PA0MHE/CNBL-10G-Addon-module/CNBL 10GHz V03.jpg

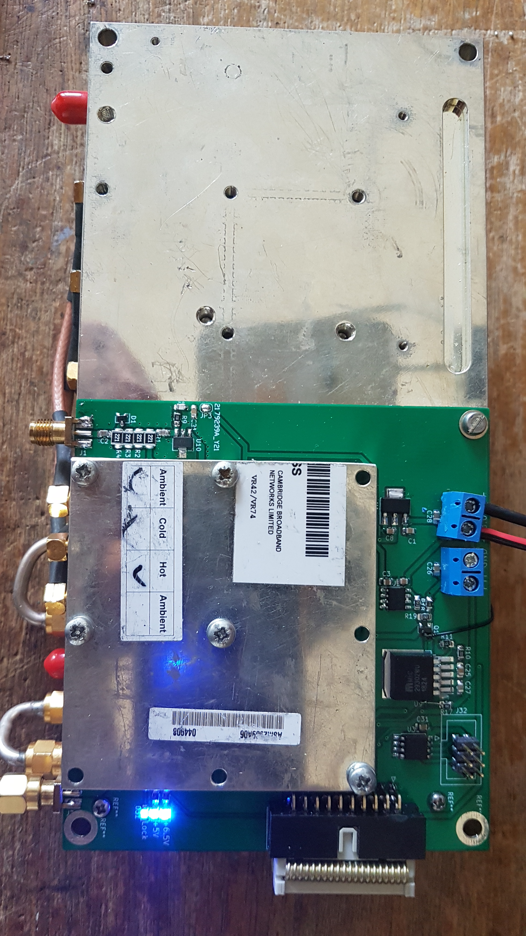
CNBL 10GHz V03.jpg
