PA0MHE/CNBL-10G-Addon-module/3D PCB.JPG

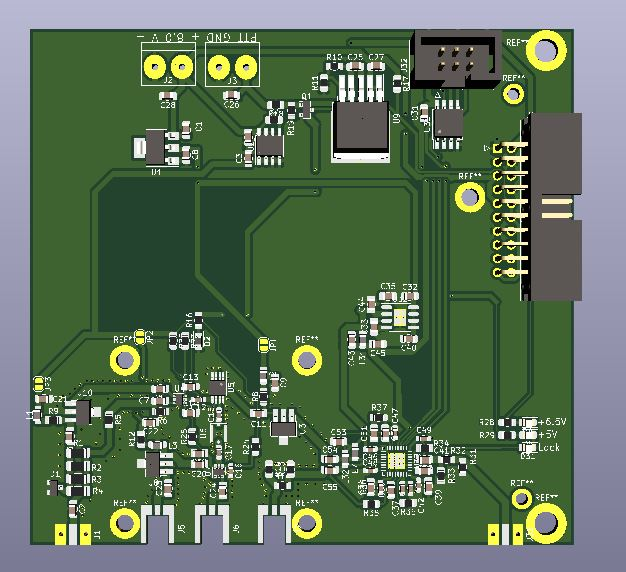
3D PCB.JPG
