PA0MHE/CNBL-10G-Addon-module/CNBL 10G v031 schematic.pdf

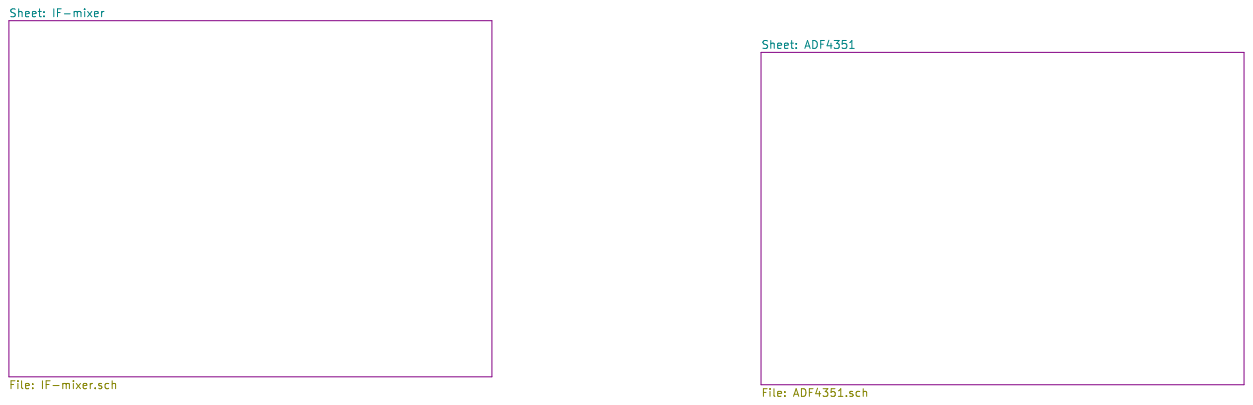
[picture p3: page 1]

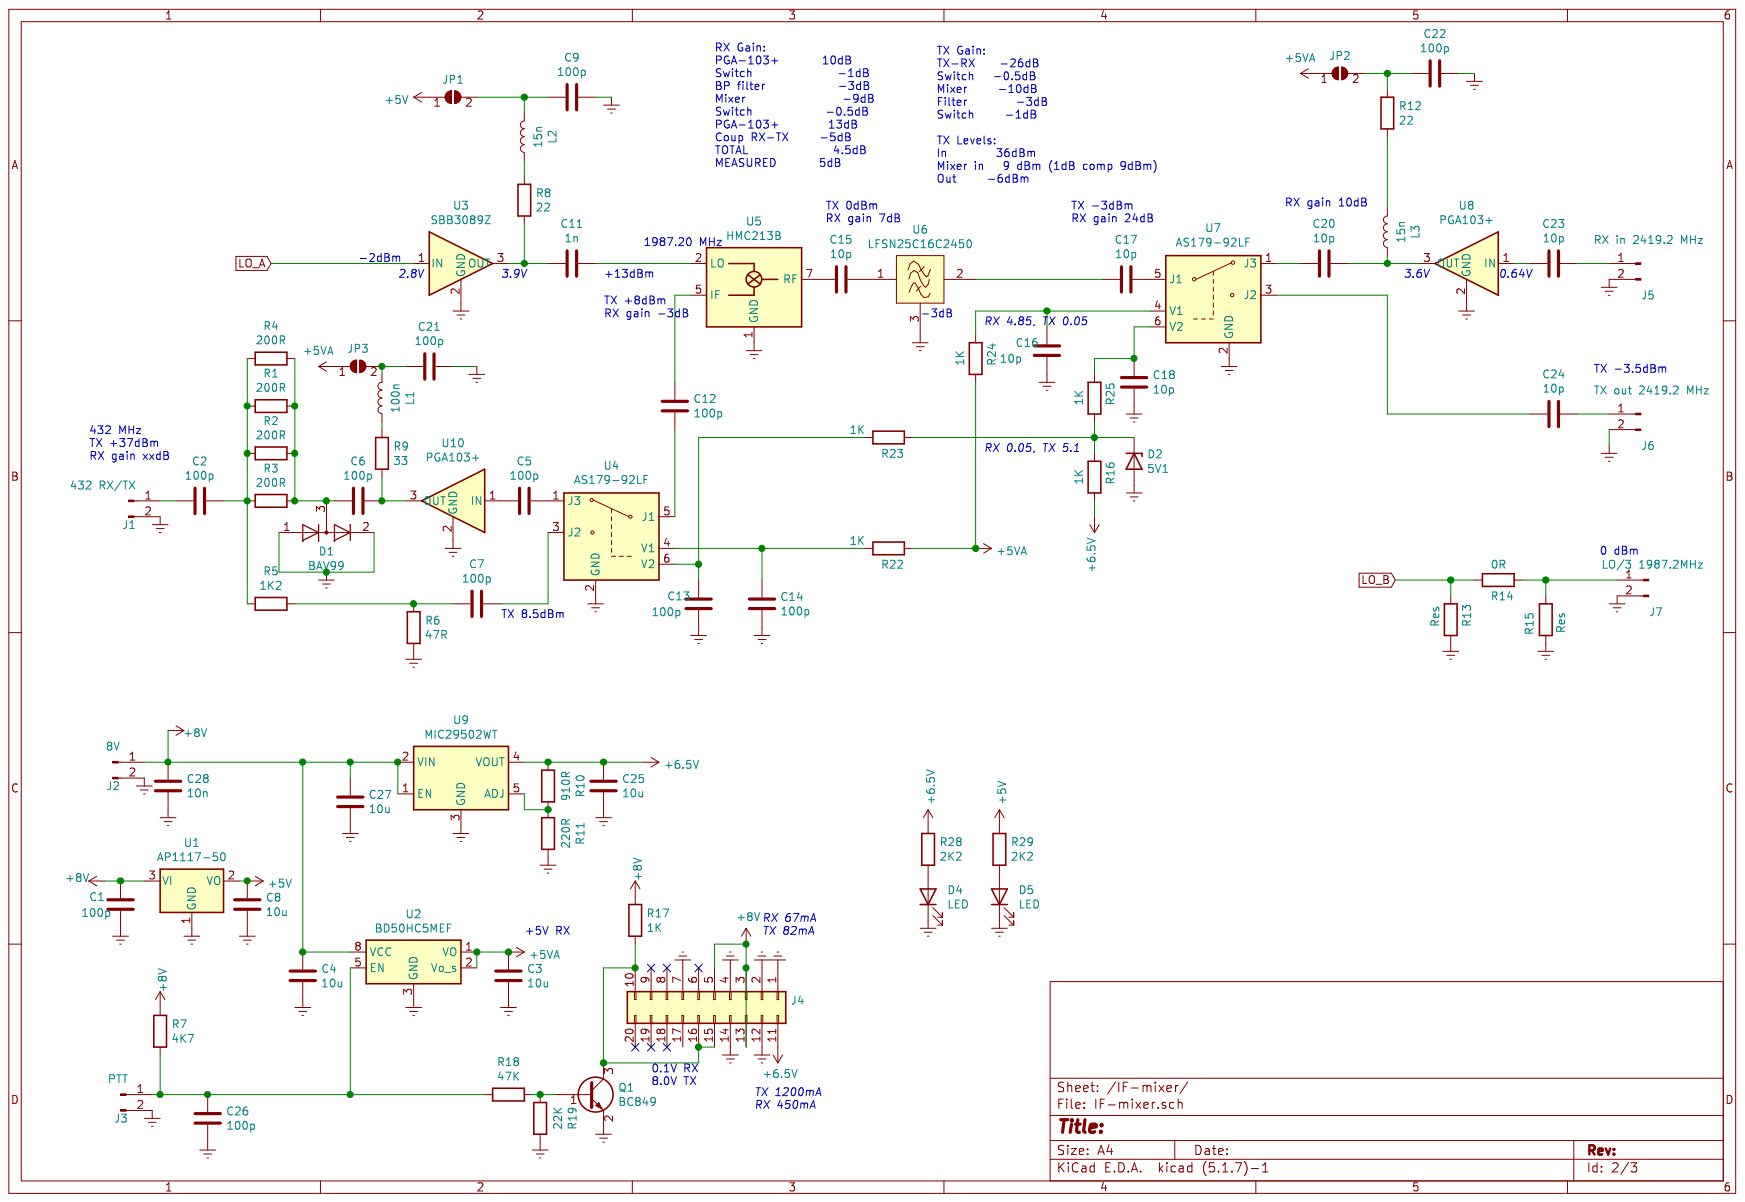
[picture p4: page 2]

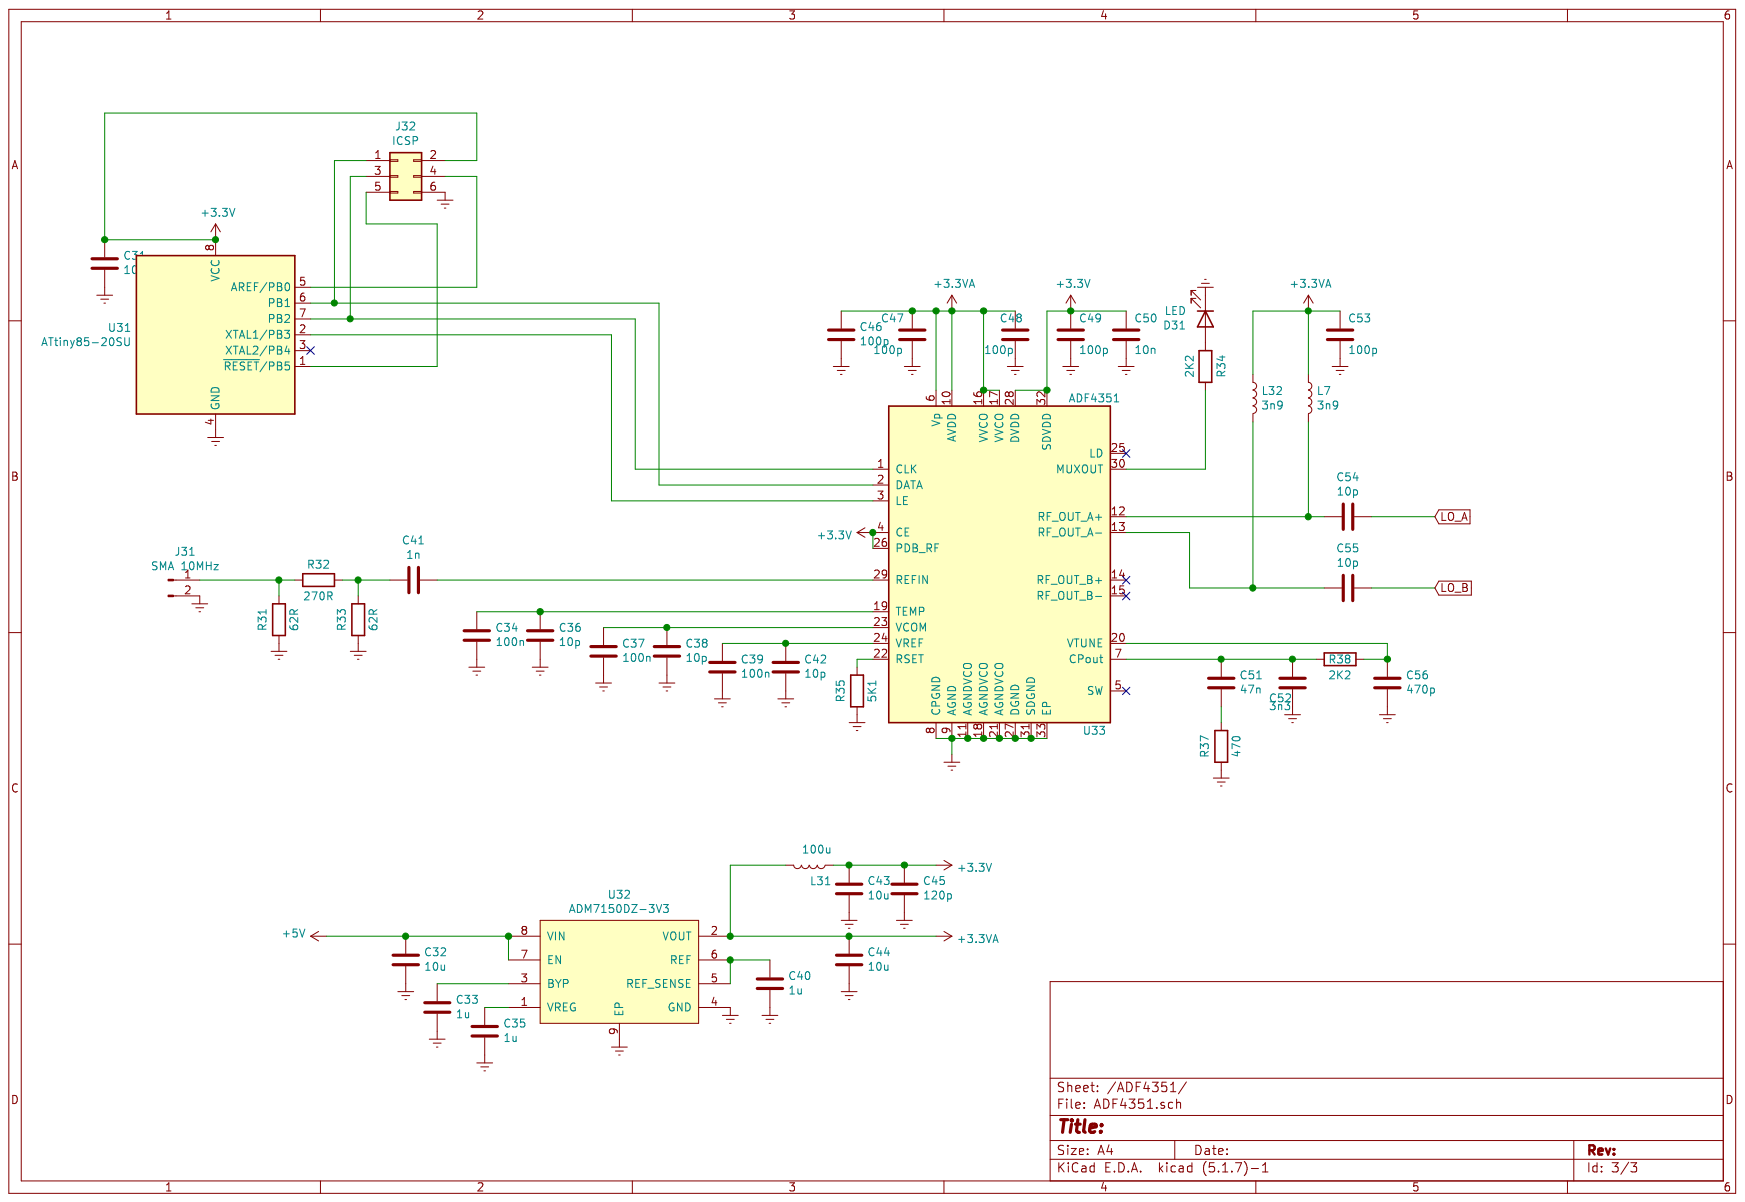
[picture p5: page 3]
