PA0MHE/CNBL-10G-Addon-module/Kicad 5 - CBNL 10GHz TRV v03/CBNL_10GHz_TRV.kicad_pcb

## KiCad design Kicad 5 - CBNL 10GHz TRV v03/CBNL_10GHz_TRV.kicad_pcb (2022-08-22)

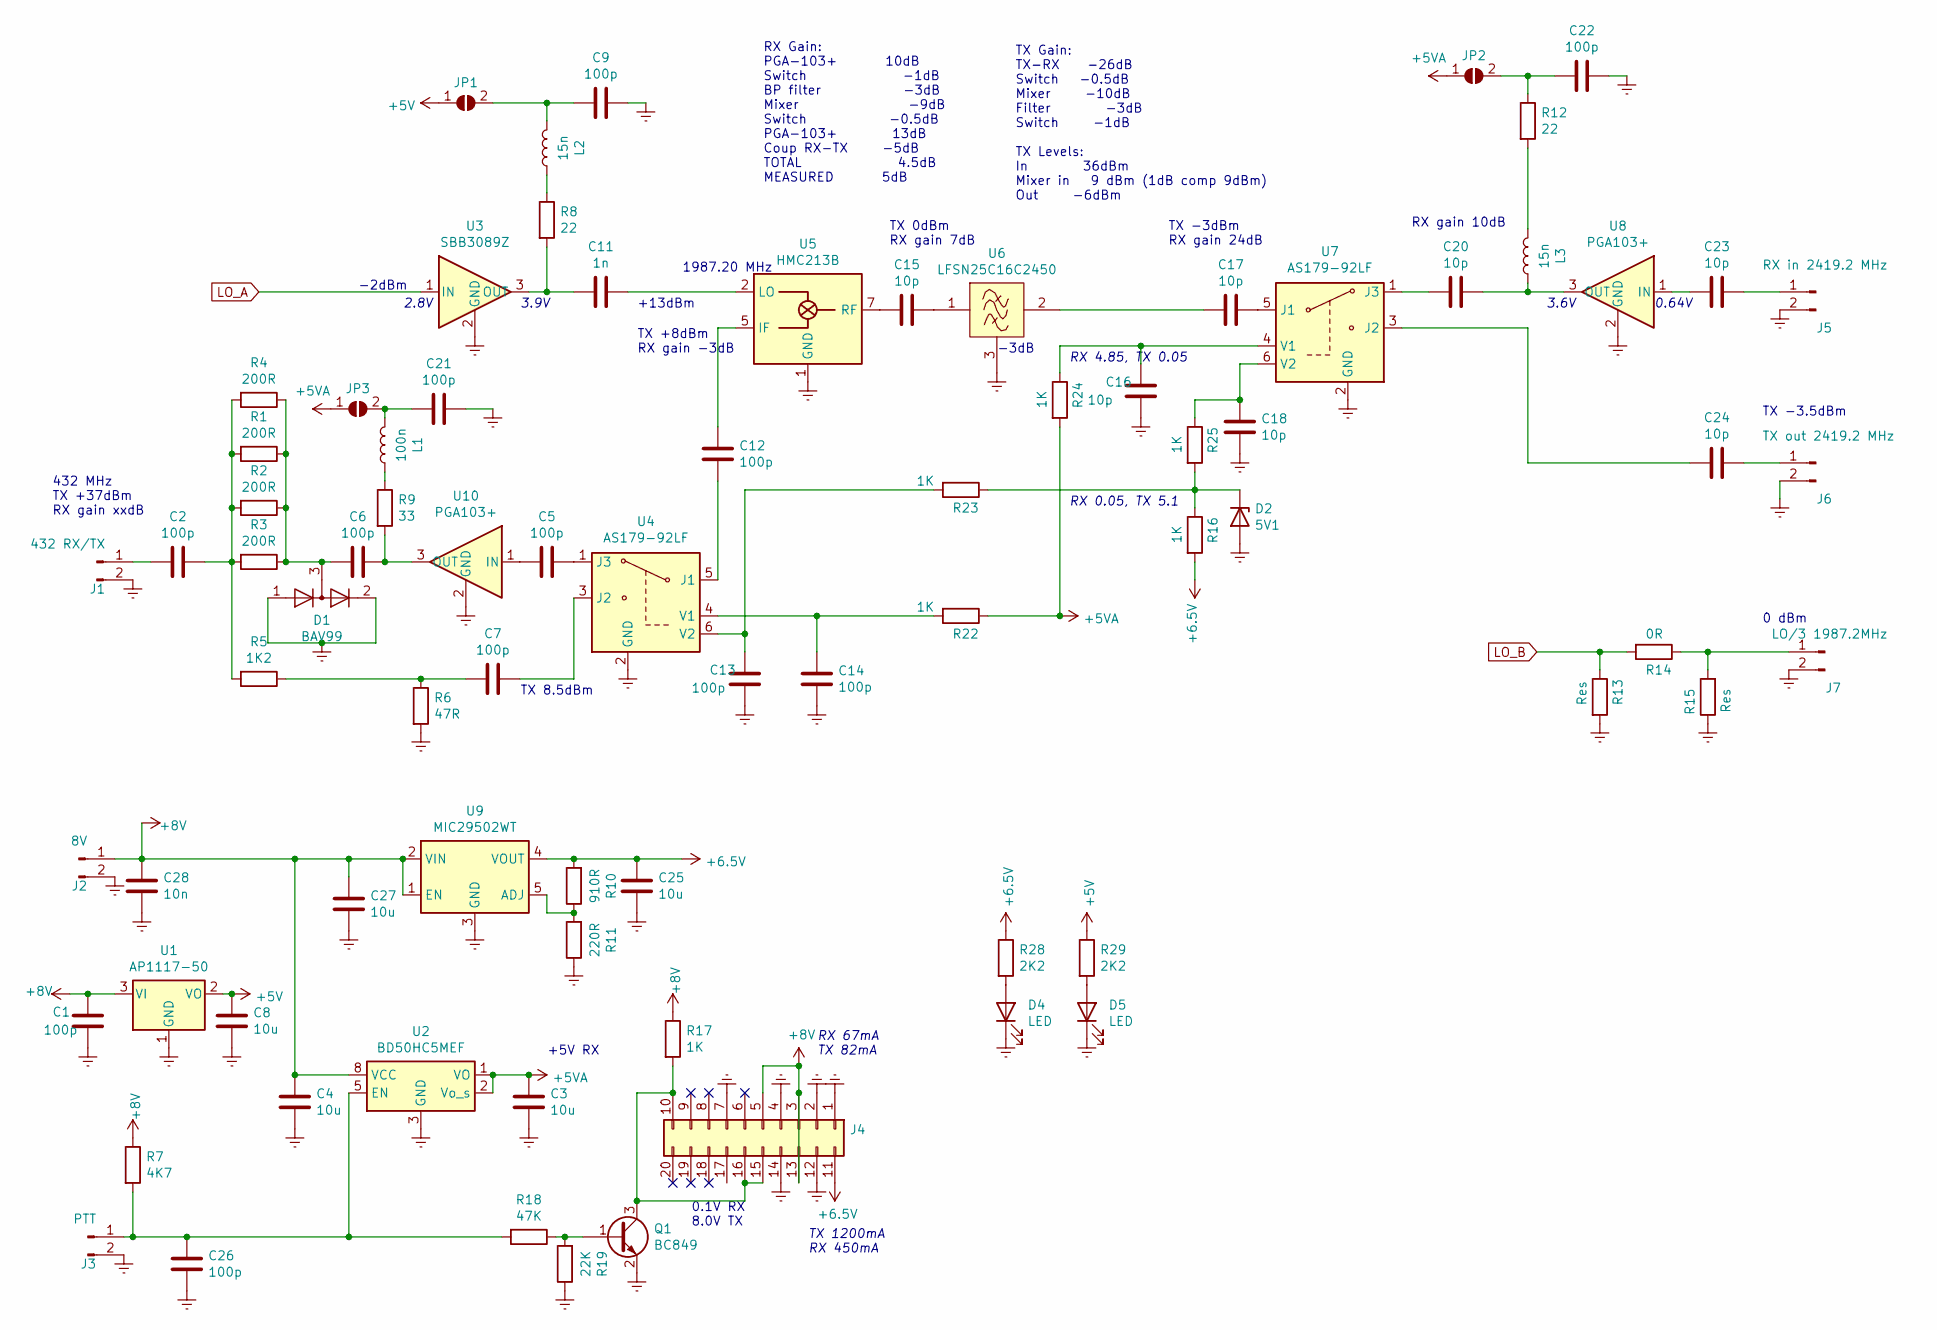
[picture p6: schematic IF-mixer.sch]

Parts:
C1, C2, C5, C6, C7, C9, C13, C14, C21, C22, C26: 100p; C_0805_2012Metric_Pad1.18x1.45mm_HandSolder
C3, C4, C8, C25, C27: 10u; C_0805_2012Metric_Pad1.18x1.45mm_HandSolder
C11: 1n; C_0805_2012Metric_Pad1.18x1.45mm_HandSolder
C12: 100p; C_0603_1608Metric_Pad1.08x0.95mm_HandSolder
C15, C16, C17: 10p; C_0603_1608Metric_Pad1.08x0.95mm_HandSolder
C18, C20, C23, C24: 10p; C_0805_2012Metric_Pad1.18x1.45mm_HandSolder
C28: 10n; C_0805_2012Metric_Pad1.18x1.45mm_HandSolder
D1: BAV99; SOT-23
D2: 5V1; D_0805_2012Metric_Pad1.15x1.40mm_HandSolder
D4, D5: LED; LED_0805_2012Metric_Pad1.15x1.40mm_HandSolder
J1: 432 RX/TX; SMA_side_PCB
J2: 8V; KF301-2P
J3: PTT; KF301-2P
J4: Conn_02x10_Top_Bottom; IDC-Header_2x10_P2.54mm_Horizontal_MH
J5: RX in 2419.2 MHz; MCX
J6: TX out 2419.2 MHz; MCX
J7: LO/3 1987.2MHz; MCX
JP1, JP2, JP3: option; SolderJumper-2_P1.3mm_Open_RoundedPad1.0x1.5mm
L1: 100n; L_0805_2012Metric_Pad1.05x1.20mm_HandSolder
L2, L3: 15n; L_0805_2012Metric_Pad1.05x1.20mm_HandSolder
Q1: BC849; SOT-23
R1, R2, R3, R4: 200R; R_1206_3216Metric_Pad1.30x1.75mm_HandSolder
R5: 1K2; R_0805_2012Metric_Pad1.20x1.40mm_HandSolder
R6: 47R; R_0805_2012Metric_Pad1.20x1.40mm_HandSolder
R7: 4K7; R_0805_2012Metric_Pad1.20x1.40mm_HandSolder
R8, R12: 22; R_0805_2012Metric_Pad1.20x1.40mm_HandSolder
R9: 33; R_0805_2012Metric_Pad1.20x1.40mm_HandSolder
R10: 910R; R_0805_2012Metric_Pad1.20x1.40mm_HandSolder
R11: 220R; R_0805_2012Metric_Pad1.20x1.40mm_HandSolder
R13, R15: Res; R_0805_2012Metric_Pad1.20x1.40mm_HandSolder
R14: 0R; R_0805_2012Metric_Pad1.20x1.40mm_HandSolder
R16, R17, R22, R23, R24, R25: 1K; R_0805_2012Metric_Pad1.20x1.40mm_HandSolder
R18: 47K; R_0805_2012Metric_Pad1.20x1.40mm_HandSolder
R19: 22K; R_0805_2012Metric_Pad1.20x1.40mm_HandSolder
R28, R29: 2K2; R_0805_2012Metric_Pad1.20x1.40mm_HandSolder
U1: AP1117-50; SOT-223-3_TabPin2
U2: BD50HC5MEF; HTSOP-8-1EP_3.9x4.9mm_P1.27mm_EP2.4x3.2mm
U3: SBB3089Z; SOT-89-3_Handsoldering
U4, U7: AS179-92LF; SOT-363_SC-70-6
U5: HMC213B; MSOP-8_3x3mm_P0.65mm
U6: LFSN25C16C2450; LFSN25N
U8, U10: PGA103+; SOT-89-3_Handsoldering
U9: MIC29502WT; TO-263-5_TabPin6

Connections:
+5V: C8.1, JP1.1 (A), R29.1, U1.2 (VO); also elsewhere on the board
+5VA: C3.1, JP2.1 (A), JP3.1 (A), R22.1, R24.2, U2.1 (VO), U2.2 (Vo_s)
+6.5V: C25.1, J4.11, R10.2, R16.2, R28.1, U9.4 (VOUT)
+8V: C1.1, C4.1, C27.1, C28.1, J2.1, J4.3, J4.5, J4.13, R7.1, R17.1, U1.3 (VI), U2.8 (VCC), U9.1 (EN), U9.2 (VIN)
GND: C1.2, C3.2, C4.2, C8.2, C9.1, C13.2, C14.2, C16.2, C18.2, C21.1, C22.1, C25.2, C26.2, C27.2, C28.2, D1.1 (K), D1.2 (A), D2.2 (A), D4.1 (K), D5.1 (K), J1.2, J2.2, J3.2, J4.1, J4.2, J4.4, J4.7, J4.12, J4.14, J5.2, J6.2, J7.2, Q1.2 (E), R6.2, R11.1, R13.2, R15.1, R19.1, U1.1 (GND), U2.3 (GND), U2.4 (GND), U2.6 (GND), U2.7 (GND), U2.9 (GND), U3.2 (GND), U4.2 (GND), U5.1 (GND), U5.3 (GND), U5.4 (GND), U5.6 (GND), U5.8 (GND), U6.3, U6.4, U7.2 (GND), U8.2 (GND), U9.3 (GND), U10.2 (GND); also elsewhere on the board
LO_A: U3.1 (IN); also elsewhere on the board
LO_B: R13.1, R14.2; also elsewhere on the board
unnamed: C2.1, R1.2, R2.2, R3.2, R4.2, R5.2
unnamed: C2.2, J1.1
unnamed: C5.1, U4.1 (J3)
unnamed: C5.2, U10.1 (IN)
unnamed: C6.1, R9.2, U10.3 (OUT)
unnamed: C6.2, D1.3 (K), R1.1, R2.1, R3.1, R4.1
unnamed: C7.1, U4.3 (J2)
unnamed: C7.2, R5.1, R6.1
unnamed: C9.2, JP1.2 (B), L2.2
unnamed: C11.1, U5.2 (LO)
unnamed: C11.2, R8.2, U3.3 (OUT)
unnamed: C12.1, U5.5 (IF)
unnamed: C12.2, U4.5 (J1)
unnamed: C13.1, R23.2, U4.6 (V2)
unnamed: C14.1, R22.2, U4.4 (V1)
unnamed: C15.1, U6.1
unnamed: C15.2, U5.7 (RF)
unnamed: C16.1, R24.1, U7.4 (V1)
unnamed: C17.1, U7.5 (J1)
unnamed: C17.2, U6.2
unnamed: C18.1, R25.1, U7.6 (V2)
unnamed: C20.1, L3.1, U8.3 (OUT)
unnamed: C20.2, U7.1 (J3)
unnamed: C21.2, JP3.2 (B), L1.2
unnamed: C22.2, JP2.2 (B), R12.1
unnamed: C23.1, J5.1
unnamed: C23.2, U8.1 (IN)
unnamed: C24.1, J6.1
unnamed: C24.2, U7.3 (J2)
unnamed: C26.1, J3.1, R7.2, R18.2, U2.5 (EN)
unnamed: D2.1 (K), R16.1, R23.1, R25.2
unnamed: D4.2 (A), R28.2
unnamed: D5.2 (A), R29.2
unnamed: J4.10, J4.15, J4.16, Q1.3 (C), R17.2
unnamed: J7.1, R14.1, R15.2
unnamed: L1.1, R9.1
unnamed: L2.1, R8.1
unnamed: L3.2, R12.2
unnamed: Q1.1 (B), R18.1, R19.2
unnamed: R10.1, R11.2, U9.5 (ADJ)

Notes on the sheet:
1987.20 MHz
-2dBm
TX +8dBm RX gain -3dB
TX 0dBm RX gain 7dB
TX -3dBm RX gain 24dB
+13dBm
0 dBm
-3dB
TX -3.5dBm
RX gain 10dB
3.9V
2.8V
3.6V
0.64V
RX 4.85, TX 0.05
RX 0.05, TX 5.1
RX 67mA TX 82mA
TX 1200mA RX 450mA
TX 8.5dBm
432 MHz TX +37dBm RX gain xxdB
+5V RX
RX Gain: PGA-103+ 10dB Switch -1dB BP filter -3dB Mixer -9dB Switch -0.5dB PGA-103+ 13dB Coup RX-TX -5dB TOTAL 4.5dB MEASURED 5dB
TX Gain: TX-RX -26dB Switch -0.5dB Mixer -10dB Filter -3dB Switch -1dB TX Levels: In 36dBm Mixer in 9 dBm (1dB comp 9dBm) Out -6dBm
0.1V RX 8.0V TX

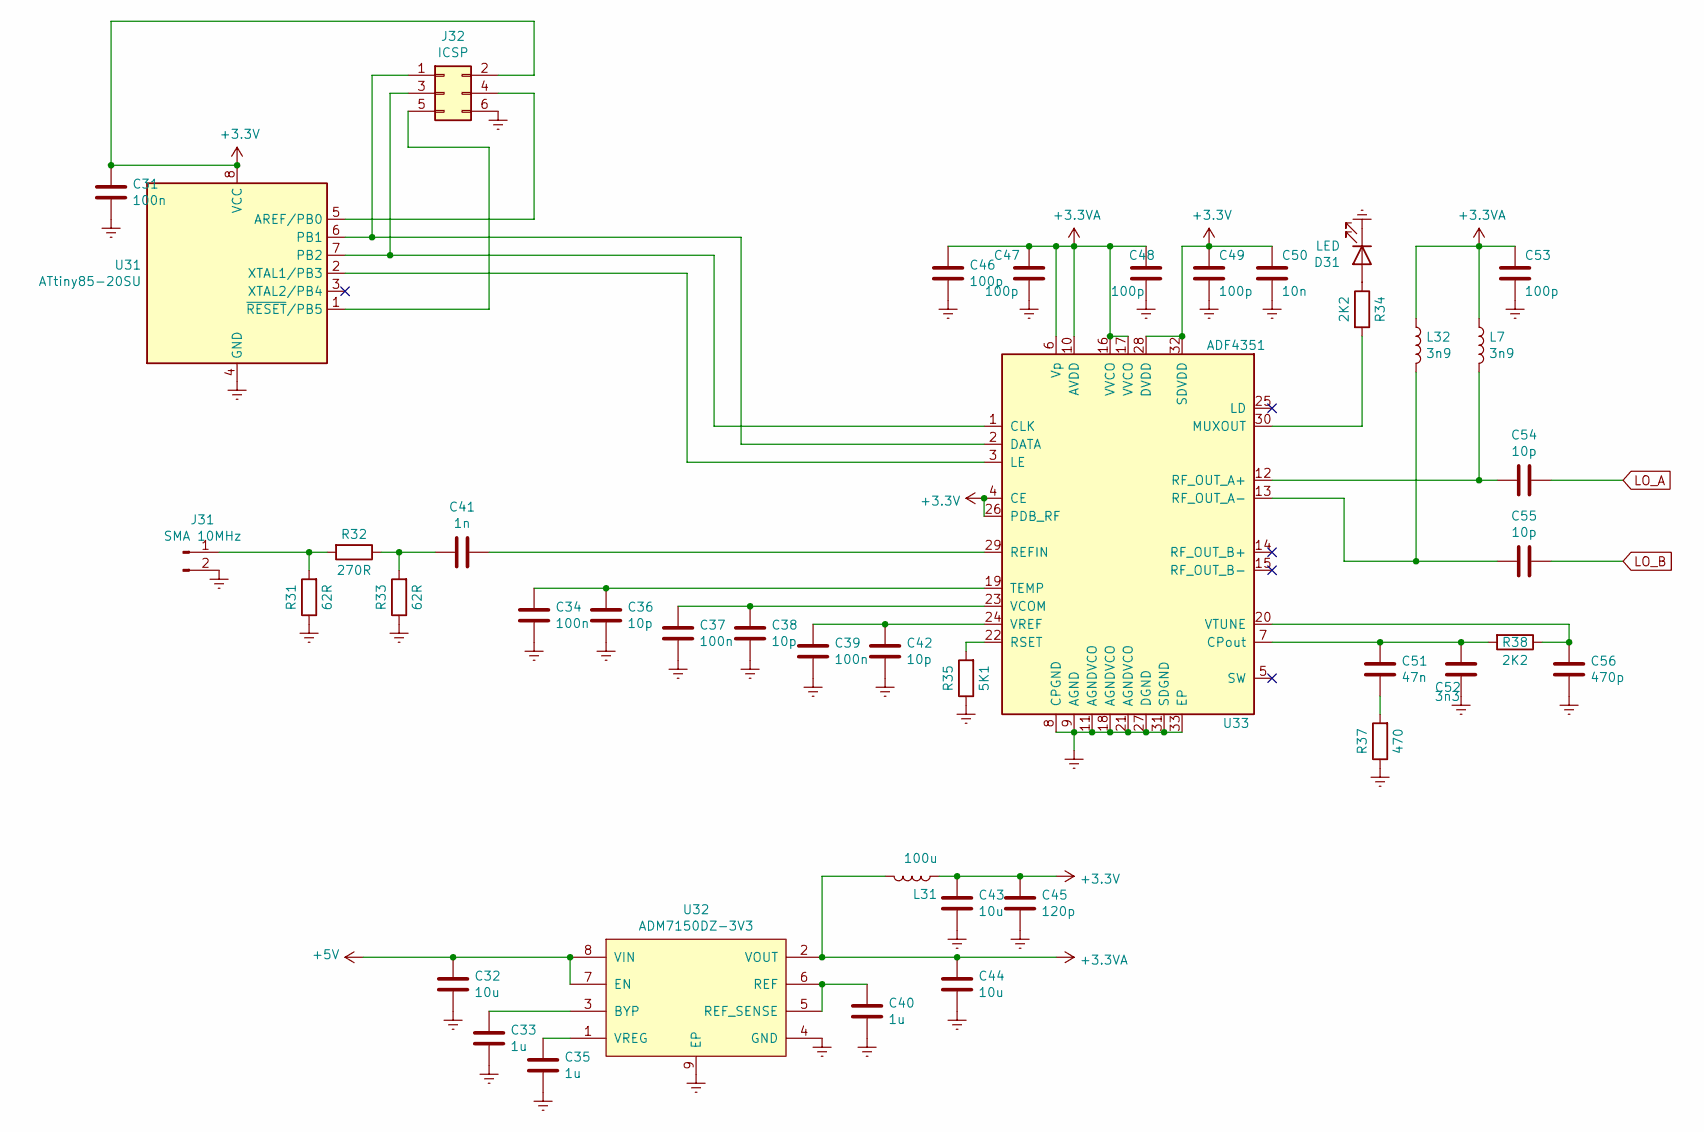
[picture p7: schematic ADF4351.sch]

Parts:
C31, C34, C39: 100n; C_0805_2012Metric_Pad1.18x1.45mm_HandSolder
C32, C43, C44: 10u; C_0805_2012Metric_Pad1.18x1.45mm_HandSolder
C33, C35, C40: 1u; C_0805_2012Metric_Pad1.18x1.45mm_HandSolder
C36, C38, C42: 10p; C_0603_1608Metric_Pad1.08x0.95mm_HandSolder
C37: 100n; C_0603_1608Metric_Pad1.08x0.95mm_HandSolder
C41: 1n; C_0805_2012Metric_Pad1.18x1.45mm_HandSolder
C45: 120p; C_0805_2012Metric_Pad1.18x1.45mm_HandSolder
C46, C47, C48, C49: 100p; C_0603_1608Metric_Pad1.08x0.95mm_HandSolder
C50: 10n; C_0805_2012Metric_Pad1.18x1.45mm_HandSolder
C51: 47n; C_0805_2012Metric_Pad1.18x1.45mm_HandSolder
C52: 3n3; C_0805_2012Metric_Pad1.18x1.45mm_HandSolder
C53: 100p; C_0805_2012Metric_Pad1.18x1.45mm_HandSolder
C54, C55: 10p; C_0805_2012Metric_Pad1.18x1.45mm_HandSolder
C56: 470p; C_0805_2012Metric_Pad1.18x1.45mm_HandSolder
D31: LED; LED_0805_2012Metric_Pad1.15x1.40mm_HandSolder
J31: SMA 10MHz; SMA_side_PCB
J32: ICSP; IDC-Header_2x03_P2.54mm_SMD
L7, L32: 3n9; L_0805_2012Metric_Pad1.05x1.20mm_HandSolder
L31: 100u; L_0805_2012Metric_Pad1.05x1.20mm_HandSolder
R31, R33: 62R; R_0805_2012Metric_Pad1.20x1.40mm_HandSolder
R32: 270R; R_0805_2012Metric_Pad1.20x1.40mm_HandSolder
R34, R38: 2K2; R_0805_2012Metric_Pad1.20x1.40mm_HandSolder
R35: 5K1; R_0805_2012Metric_Pad1.20x1.40mm_HandSolder
R37: 470; R_0805_2012Metric_Pad1.20x1.40mm_HandSolder
U31: ATtiny85-20SU; SOIJ-8_5.3x5.3mm_P1.27mm
U32: ADM7150DZ-3V3; SOIC-8-1EP_3.9x4.9mm_P1.27mm_EP2.29x3mm_ThermalVias
U33: ADF4351; LFCSP-32-1EP_5x5mm_P0.5mm_EP3.1x3.1mm_ThermalVias

Connections:
+3.3VA: C44.2, C46.2, C47.2, C48.2, C53.2, L7.1, L31.2, L32.1, U32.2 (VOUT), U33.6 (Vp), U33.10 (AVDD), U33.16 (VVCO), U33.17 (VVCO)
+3V3: C31.2, C43.2, C45.2, C49.2, C50.2, J32.2, L31.1, U31.8 (VCC), U33.4 (CE), U33.26 (PDB_RF), U33.28 (DVDD), U33.32 (SDVDD)
+5V: C32.2, U32.7 (EN), U32.8 (VIN); also elsewhere on the board
GND: C31.1, C32.1, C33.1, C34.1, C35.1, C36.1, C37.1, C38.1, C39.1, C40.1, C42.1, C43.1, C44.1, C45.1, C46.1, C47.1, C48.1, C49.1, C50.1, C52.1, C53.1, C56.1, D31.1 (K), J31.2, J32.6, R31.1, R33.1, R35.1, R37.1, U31.4 (GND), U32.4 (GND), U32.9 (EP), U33.8 (CPGND), U33.9 (AGND), U33.11 (AGNDVCO), U33.18 (AGNDVCO), U33.21 (AGNDVCO), U33.27 (DGND), U33.31 (SDGND), U33.33 (EP); also elsewhere on the board
LO_A: C54.1; also elsewhere on the board
LO_B: C55.1; also elsewhere on the board
unnamed: C33.2, U32.3 (BYP)
unnamed: C34.2, C36.2, U33.19 (TEMP)
unnamed: C35.2, U32.1 (VREG)
unnamed: C37.2, C38.2, U33.23 (VCOM)
unnamed: C39.2, C42.2, U33.24 (VREF)
unnamed: C40.2, U32.5 (REF_SENSE), U32.6 (REF)
unnamed: C41.1, U33.29 (REFIN)
unnamed: C41.2, R32.1, R33.2
unnamed: C51.1, R37.2
unnamed: C51.2, C52.2, R38.2, U33.7 (CPout)
unnamed: C54.2, L7.2, U33.12 (RF_OUT_A+)
unnamed: C55.2, L32.2, U33.13 (RF_OUT_A-)
unnamed: C56.2, R38.1, U33.20 (VTUNE)
unnamed: D31.2 (A), R34.1
unnamed: J31.1, R31.2, R32.2
unnamed: J32.1, U31.6 (PB1), U33.2 (DATA)
unnamed: J32.3, U31.7 (PB2), U33.1 (CLK)
unnamed: J32.4, U31.5 (AREF/PB0)
unnamed: J32.5, U31.1 (~RESET~/PB5)
unnamed: R34.2, U33.30 (MUXOUT)
unnamed: R35.2, U33.22 (RSET)
unnamed: U31.2 (XTAL1/PB3), U33.3 (LE)

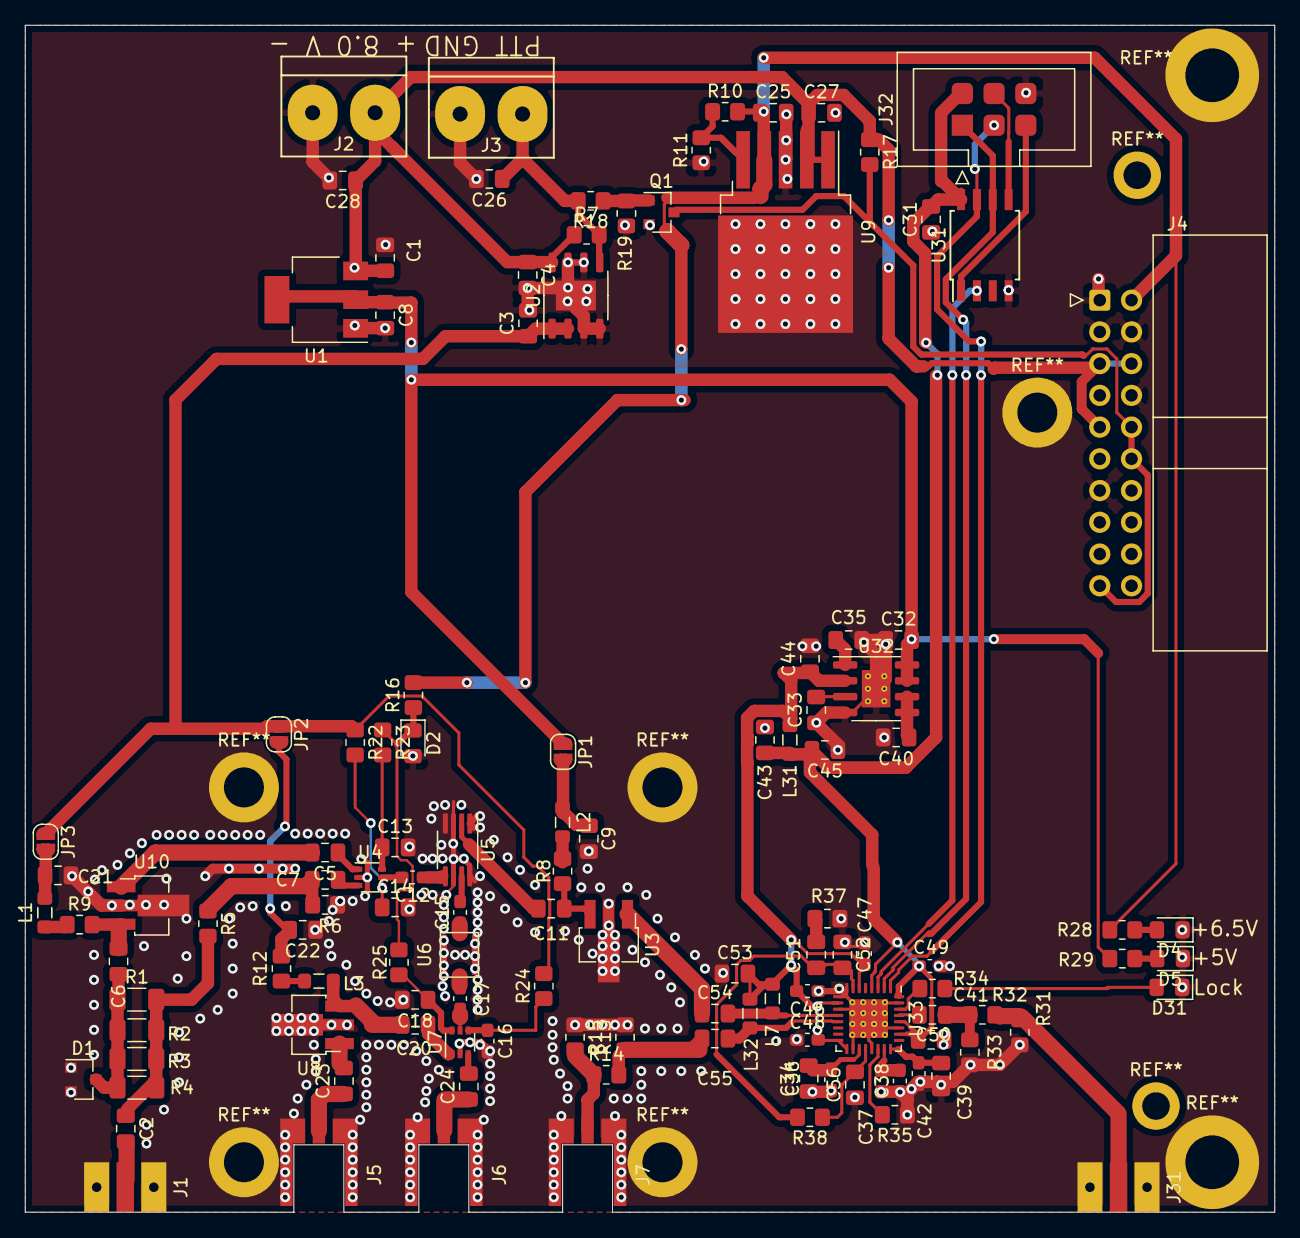
[picture p8: board CBNL_10GHz_TRV.kicad_pcb from above]

Board: 2 copper layers, 100.0 x 95.0 mm, 121 parts (0 on the bottom side), 71 nets.
